lhr-solar/PS-PowerDistributionUnit/hardware/external_part/TPS2HCS08AQPWPRQ1/TPS2HCS08AQPWPRQ1.stp

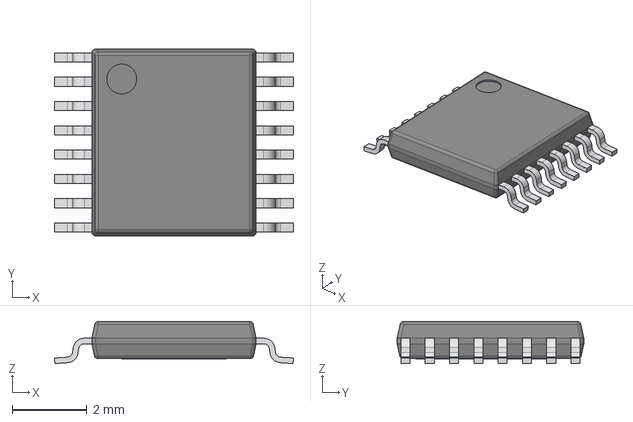
[picture p1: CAD file, 2026-11-02]
hardware/external_part/TPS2HCS08AQPWPRQ1/TPS2HCS08AQPWPRQ1.stp
6.40 x 5.00 x 1.13 mm
