lhr-solar/PS-PowerDistributionUnit/hardware/TestBoard_TPS27SA08-Q1/out/TestBoard_TPS27SA08-Q1.pdf

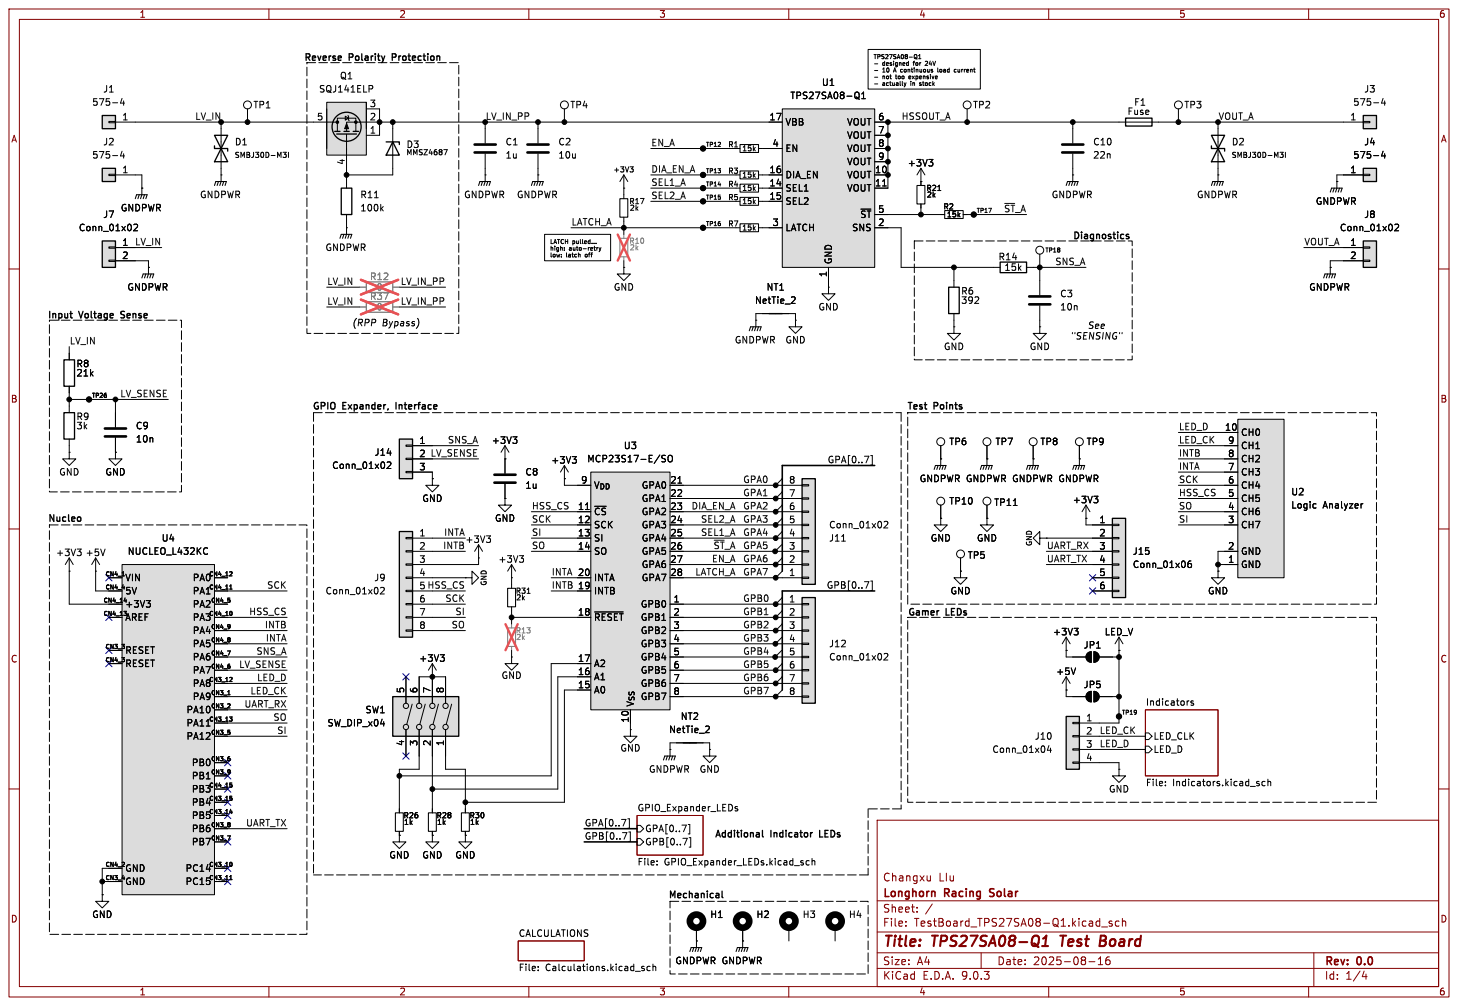
[picture p2: page 1]

LATCH pulled... high: auto-retry

LED_D
Logic Analyzer CH3 7 CH4 6 CH5 5 CH6 4 CH7 3 GND 2 GND 1 CH0 10 CH1 9 CH2 8 GND

V_{DD} 9 ~{CS} 11 SCK 12 SI 13 SO 14

Indicators File: Indicators.kicad_sch CALCULATIONS

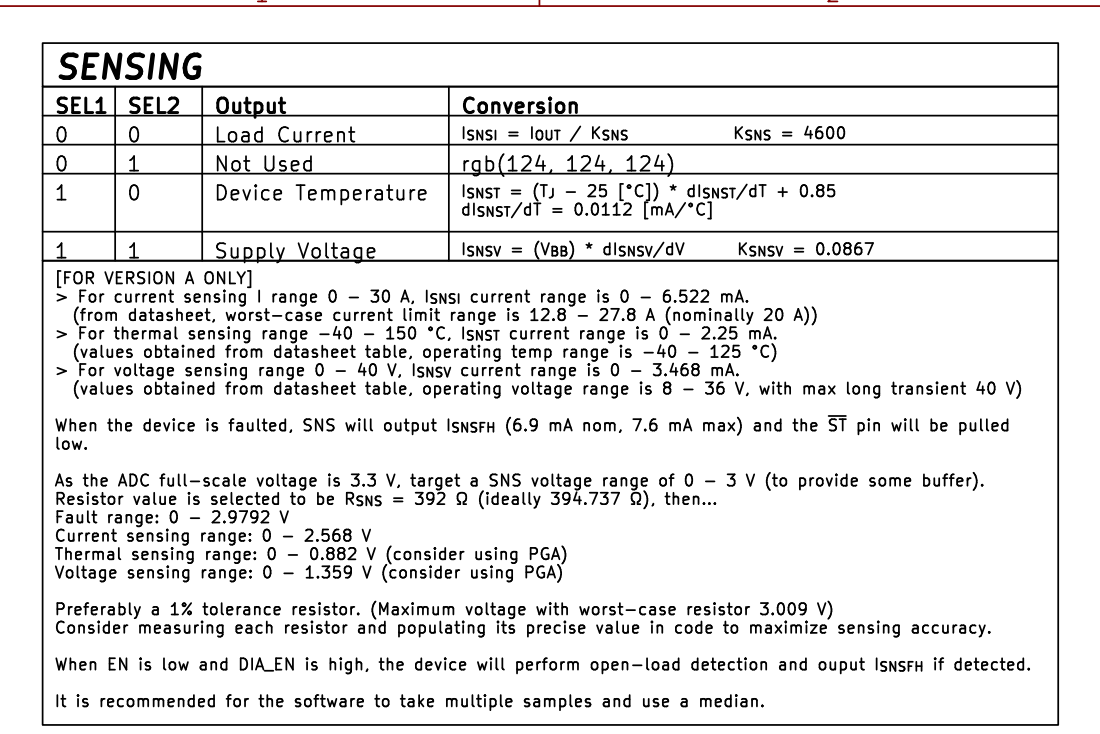
[picture p3: page 2]

1 | Supply Voltage | dI_{SNST}/dT= 0.0112 I_{SNSV} = (V_{BB})* dI_{SNSV}/dV þÿ[mA/°C] 1 K_{SNSV} = 0.0867 SENSING
SEL1 | SEL2 | Output | Conversion
0 | 0 1 0 | Load Current Not Used Device Temperature | I_{SNSI}= I_{OUT} / K_{SNS} rgb(124, I_{SNST} = (T_{J}- 25 124, 124) 1 | þÿ[°C]) * dI_{SNST}/dT+ 0.85 | K_{SNS}= 4600 0

Id: 2/4 Title: File: Calculations.kicad_sch Sheet: /CALCULATIONS/

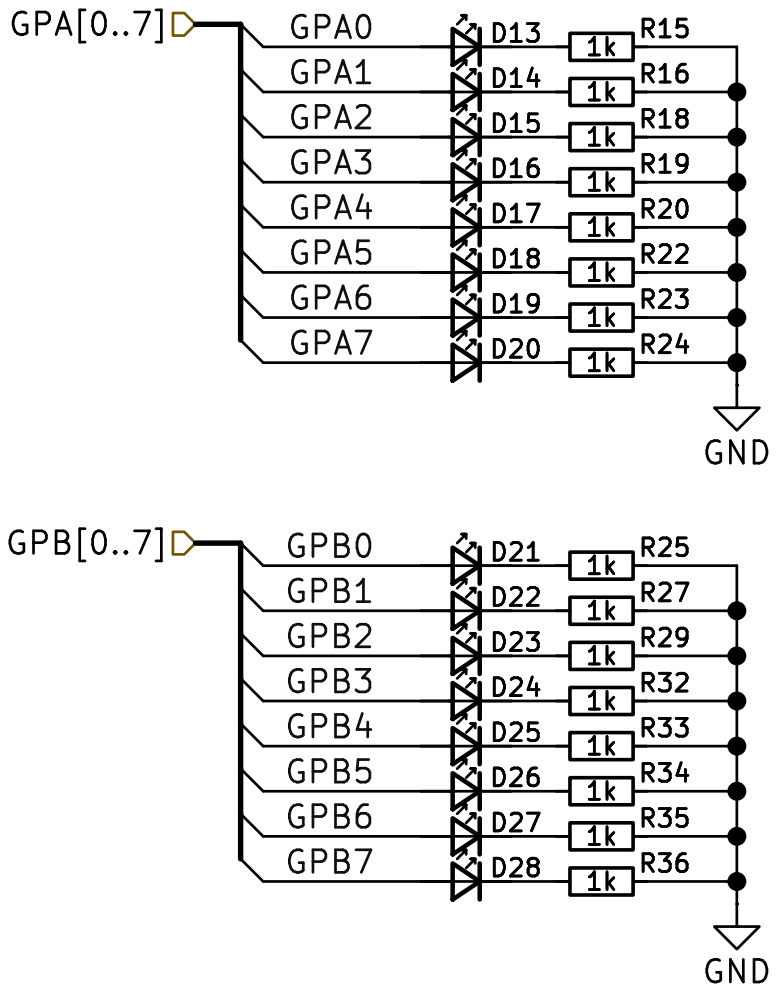
[picture p4: page 3]

Id: 4/4 Title: File: GPIO_Expander_LEDs.kicad_sch Sheet: /GPIO_Expander_LEDs/

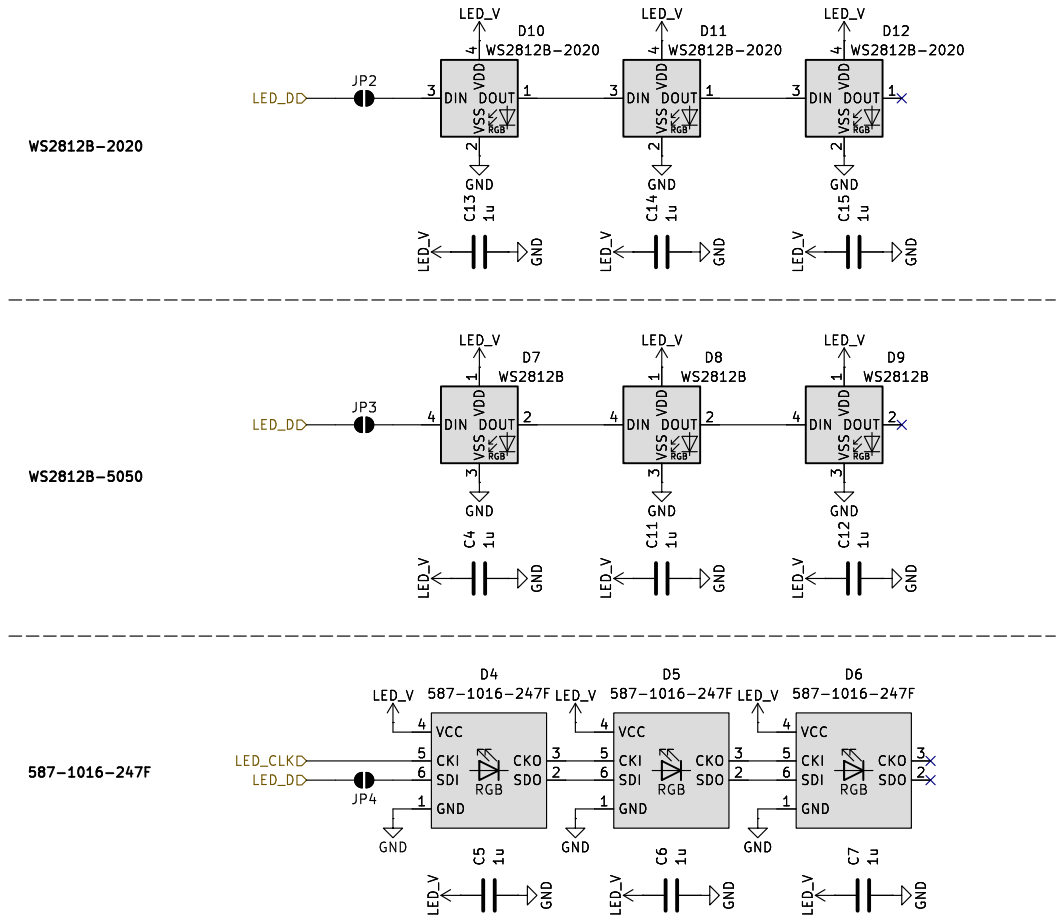
[picture p5: page 4]

Id: 3/4 Title: File: Indicators.kicad_sch Sheet: /Indicators/ LED_V
