lhr-solar/PS-PowerDistributionUnit/firmware/PowerDistributionUnit_Mk1/core/src/main.c

// main.c
// ----------------------------------------------------------------------------

// INCLUDES -------------------------------------------------------------------

#include "stm32xx_hal.h"
// stm32xx_hal.h contains includes for RTOS stuff.
#include<stdio.h>
#include<string.h>

// Tasks
#include "Task_Init.h"

// DEFINES --------------------------------------------------------------------

#define INTERVAL_BLINK_ERROR_MS 50

// DECLARATIONS ---------------------------------------------------------------

// SPI1
SPI_HandleTypeDef hspi1;                // Handle
SemaphoreHandle_t spi1_mutex;           // Mutex to prevent simultaneous SPI access
StaticSemaphore_t spi1_mutex_buffer;    // SPI mutex buffer
SemaphoreHandle_t spi1_done_sem;        // Semaphore to signal SPI IT completion
StaticSemaphore_t spi1_done_sem_buffer; // SPI completion sempahore buffer

// SPI2
SPI_HandleTypeDef hspi2;
SemaphoreHandle_t spi2_mutex;
StaticSemaphore_t spi2_mutex_buffer;
SemaphoreHandle_t spi2_done_sem;
StaticSemaphore_t spi2_done_sem_buffer;

// SPI3
SPI_HandleTypeDef hspi3;
SemaphoreHandle_t spi3_mutex;
StaticSemaphore_t spi3_mutex_buffer;
SemaphoreHandle_t spi3_done_sem;
StaticSemaphore_t spi3_done_sem_buffer;

// Task: Init
StaticTask_t init_task_buffer;                          // Task buffer
StackType_t init_task_stack[TASK_INIT_STACK_SIZE];      // Task stack

// MAIN -----------------------------------------------------------------------

int main()
{
    HAL_Init();
    SystemClock_Config();

    xTaskCreateStatic(Task_Init,
                    "Init Task",
                    TASK_INIT_STACK_SIZE,
                    NULL,
                    TASK_INIT_PRIORITY,
                    init_task_stack,
                    &init_task_buffer
                );

    vTaskStartScheduler();

    while(1) {}
}

// ERROR HANDLER --------------------------------------------------------------

void Error_Handler(void)
{
    while(1)
    {
        HAL_GPIO_TogglePin(LED_PORT, LED_PIN);
        vTaskDelay(pdMS_TO_TICKS(INTERVAL_BLINK_ERROR_MS));
    }
}
