lhr-solar/PS-PowerDistributionUnit/hardware/hardware.ioc

Mcu.UserName=STM32G473CETx
PA0.Signal=GPIO_Output
PA15.Signal=GPIO_Output
PA3.Signal=GPIO_Output
PA4.Signal=SPI1_NSS
PA5.Signal=SPI1_SCK
PA6.Signal=SPI1_MISO
PA7.Signal=SPI1_MOSI
PA8.Signal=GPIO_Output
PA9.Signal=GPIO_Output
PB0.Signal=GPIO_Output
PB1.Signal=GPIO_Output
PB10.Signal=GPIO_Output
PB11.Signal=GPIO_Output
PB12.Signal=FDCAN2_RX
PB13.Signal=FDCAN2_TX
PB3.Signal=GPIO_Output
PB4.Signal=GPIO_Output
PB6.Signal=GPIO_Output
PB7.Signal=GPIO_Output
PC13.Signal=GPIO_Output
PC14-OSC32_IN.Signal=GPIO_Output
