lhr-solar/PS-PowerDistributionUnit/firmware/PowerDistributionUnit_Mk1/core/src/PDU_Mk1_CurrentSensing.c

// PDU_Mk1_CurrentSensing.c

#include "PDU_Mk1_CurrentSensing.h"

ADS131M08Q1_HandleTypeDef adc_sns1;
ADS131M08Q1_HandleTypeDef adc_sns0;

float currents[PDU_MK1_NUM_CHANNELS] = {0};
float current_adc_v_offset[PDU_MK1_NUM_CHANNELS] = {0};

bool PDU_Mk1_CurrentSensing_Init()
{
#ifndef PDU_MK1_REV_A            // PDU_Mk1_REV_A has SPI pinout issue
    if(PDU_Mk1_Init_ADC_SNS0() != ADS131M08Q1_🙂)
    {
        return false;
    }
#endif

    if(PDU_Mk1_Init_ADC_SNS1() != ADS131M08Q1_🙂)
    {
        return false;
    }

    if(PDU_Mk1_CurrentSensing_CollectOffsets() != true)
    {
        return false;
    }

    return true;
}

ADS131M08Q1_Status_t PDU_Mk1_Init_ADC_SNS0()
{
    adc_sns0.spi = &hspi3;
    adc_sns0.cs_port = ADC_SNS0_CS_PORT;
    adc_sns0.cs_pin = ADC_SNS0_CS_PIN;

    adc_sns0.spi_mutex = spi3_mutex;
    adc_sns0.spi_done_sem = spi3_done_sem;
    
    for(uint8_t ch = 0; ch < ADS131M08Q1_NUM_CHANNELS; ch++)
    {
        adc_sns0.config.ch_configs[ch].enable = ADS131M08Q1_CH_ENABLE;
        adc_sns0.config.ch_configs[ch].gain = ADS131M08Q1_CH_GAIN_1;
        adc_sns0.config.ch_configs[ch].phase = ADS131M08Q1_CH_PHASE_DEFAULT;
        adc_sns0.config.ch_configs[ch].offset_cal = ADS131M08Q1_CH_OFFSET_CAL_DEFAULT;
        adc_sns0.config.ch_configs[ch].gain_cal = ADS131M08Q1_CH_GAIN_CAL_DEFAULT;
    }
    adc_sns0.config.drdy_format = ADS131M08Q1_CONFIG_DRDY_FORMAT_DEFAULT;
    adc_sns0.config.drdy_idlepinstate = ADS131M08Q1_CONFIG_DRDY_IDLEPINSTATE_DEFAULT;
    adc_sns0.config.drdy_source = ADS131M08Q1_CONFIG_DRDY_SOURCE_DEFAULT;
    adc_sns0.config.reference_source = ADS131M08Q1_CONFIG_REFERENCE_SOURCE_DEFAULT;
    adc_sns0.config.fsr = ADS131M08Q1_INTERNAL_REFERENCE_V;
    adc_sns0.config.powermode = ADS131M08Q1_CONFIG_POWERMODE_DEFAULT;

    return ADS131M08Q1_Init(&adc_sns0);
}

ADS131M08Q1_Status_t PDU_Mk1_Init_ADC_SNS1()
{
    adc_sns1.spi = &hspi2;
    adc_sns1.cs_port = ADC_SNS1_CS_PORT;
    adc_sns1.cs_pin = ADC_SNS1_CS_PIN;

    adc_sns1.spi_mutex = spi2_mutex;
    adc_sns1.spi_done_sem = spi2_done_sem;
    
    for(uint8_t ch = 0; ch < ADS131M08Q1_NUM_CHANNELS; ch++)
    {
        adc_sns1.config.ch_configs[ch].enable = ADS131M08Q1_CH_ENABLE;
        adc_sns1.config.ch_configs[ch].gain = ADS131M08Q1_CH_GAIN_1;
        adc_sns1.config.ch_configs[ch].phase = ADS131M08Q1_CH_PHASE_DEFAULT;
        adc_sns1.config.ch_configs[ch].offset_cal = ADS131M08Q1_CH_OFFSET_CAL_DEFAULT;
        adc_sns1.config.ch_configs[ch].gain_cal = ADS131M08Q1_CH_GAIN_CAL_DEFAULT;
    }
    adc_sns1.config.drdy_format = ADS131M08Q1_CONFIG_DRDY_FORMAT_DEFAULT;
    adc_sns1.config.drdy_idlepinstate = ADS131M08Q1_CONFIG_DRDY_IDLEPINSTATE_DEFAULT;
    adc_sns1.config.drdy_source = ADS131M08Q1_CONFIG_DRDY_SOURCE_DEFAULT;
    adc_sns1.config.reference_source = ADS131M08Q1_CONFIG_REFERENCE_SOURCE_DEFAULT;
    adc_sns1.config.fsr = ADS131M08Q1_INTERNAL_REFERENCE_V;
    adc_sns1.config.powermode = ADS131M08Q1_CONFIG_POWERMODE_DEFAULT;

    return ADS131M08Q1_Init(&adc_sns1);
}

bool PDU_Mk1_CurrentSensing_CollectOffsets()
{
    float adc_results_sns0[CURRENT_SENSING_OFFSET_CALC_NUMSAMPLES][ADS131M08Q1_NUM_CHANNELS] = {0};
    float adc_results_sns1[CURRENT_SENSING_OFFSET_CALC_NUMSAMPLES][ADS131M08Q1_NUM_CHANNELS] = {0};

    for(uint8_t sample = 0; sample < CURRENT_SENSING_OFFSET_CALC_NUMSAMPLES; sample++)
    {
#ifndef PDU_MK1_REV_A            // PDU_Mk1_REV_A has SPI pinout issue
        if(ADS131M08Q1_ReadConversionResults(&adc_sns0, adc_results_sns0[sample]) != ADS131M08Q1_🙂)
        {
            return false;
        }
#endif

        if(ADS131M08Q1_ReadConversionResults(&adc_sns1, adc_results_sns1[sample]) != ADS131M08Q1_🙂)
        {
            return false;
        }

        if(sample != CURRENT_SENSING_OFFSET_CALC_NUMSAMPLES-1)
        {
            vTaskDelay(pdMS_TO_TICKS(CURRENT_SENSING_OFFSET_CALC_SAMPLE_DELAY_MS));
        }
    }

    for(uint8_t ch = 0; ch < ADS131M08Q1_NUM_CHANNELS; ch++)
    {
        for(uint8_t sample = 0; sample < CURRENT_SENSING_OFFSET_CALC_NUMSAMPLES; sample++)
        {
            current_adc_v_offset[ch] += -1.0f*adc_results_sns1[sample][(ADS131M08Q1_NUM_CHANNELS-1)-ch];
            current_adc_v_offset[ADS131M08Q1_NUM_CHANNELS+ch] += -1.0f*adc_results_sns0[sample][(ADS131M08Q1_NUM_CHANNELS-1)-ch];
        }

        current_adc_v_offset[ch] /= (float) CURRENT_SENSING_OFFSET_CALC_NUMSAMPLES;
        current_adc_v_offset[ADS131M08Q1_NUM_CHANNELS+ch] /= (float) CURRENT_SENSING_OFFSET_CALC_NUMSAMPLES;
    }

    return true;
}

bool PDU_Mk1_CurrentSensing_ReadCurrents()
{
    float adc_results_sns0[ADS131M08Q1_NUM_CHANNELS] = {0};
    float adc_results_sns1[ADS131M08Q1_NUM_CHANNELS] = {0};

#ifndef PDU_MK1_REV_A            // PDU_Mk1_REV_A has SPI pinout issue
    if(ADS131M08Q1_ReadConversionResults(&adc_sns0, adc_results_sns0) != ADS131M08Q1_🙂)
    {
        return false;
    }
#endif

    if(ADS131M08Q1_ReadConversionResults(&adc_sns1, adc_results_sns1) != ADS131M08Q1_🙂)
    {
        return false;
    }

    for(uint8_t i = 0; i < ADS131M08Q1_NUM_CHANNELS; i++)
    {
        currents[i] = ACS3704x_010B3_Current_Conversion_QVOCentered(adc_results_sns1[(ADS131M08Q1_NUM_CHANNELS-1)-i]+current_adc_v_offset[i]);
        currents[ADS131M08Q1_NUM_CHANNELS+i] = ACS3704x_010B3_Current_Conversion_QVOCentered(adc_results_sns0[(ADS131M08Q1_NUM_CHANNELS-1)-i]+current_adc_v_offset[ADS131M08Q1_NUM_CHANNELS+i]);
    }

    return true;
}

float* PDU_Mk1_CurrentSensing_GetCurrentsPtr()
{
    return currents;
}

// reconfigure SPI when communicating with ADC as ADS131M08-Q1 has CPHA=1
bool ADS131M08Q1_ReconfigSPI(ADS131M08Q1_HandleTypeDef* device)
{
    if(device == &adc_sns0)
    {
        return PDU_Mk1_SPI3_ADC_Init();
    }
    else if(device == &adc_sns1)
    {
        return PDU_Mk1_SPI2_ADC_Init();
    }

    return false;
}
