lhr-solar/PS-PowerDistributionUnit/firmware/driver/inc/ADS131M08-Q1.h

// ADS131M08-Q1.h
// ----------------------------------------------------------------------------
// Driver for ADS131M08-Q1 24-bit simultaneously-sampling sigma-delta ADC
// Datasheet: datasheets/ADS131M08-Q1.pdf (from BBPDU repo root)

# pragma once

#include "stm32xx_hal.h"
#include<math.h>
#include<string.h>

#define ADS131M08Q1_SPI_MUTEX_DELAY_TICKS pdMS_TO_TICKS(1000)           // ticks
#define ADS131M08Q1_SPI_TRANSMISSION_DELAY_TICKS pdMS_TO_TICKS(100)   	// ticks
#define ADS131M08Q1_CS_DELAY_TICKS pdMS_TO_TICKS(1)						// ticks

#define ADS131M08Q1_NUM_CHANNELS 8
#define ADS131M08Q1_NUM_BITS 24
#define ADS131M08Q1_NUM_STEPS (8388608-1)   	// 2^23 (24 bits - 1 sign bit) - 1
#define ADS131M08Q1_INTERNAL_REFERENCE_V 1.2
#define ADS131M08Q1_CH_VALID_CHECK(ch) (ch < ADS131M08Q1_NUM_CHANNELS && ch >= 0)
#define ADS131M08Q1_CH_INVALID_CHECK(ch) (ch >= ADS131M08Q1_NUM_CHANNELS || ch < 0)

#define ADS131M08Q1_GAIN_CAL_MIN 0
#define ADS131M08Q1_GAIN_CAL_STEP 0.00000011920928955
#define ADS131M08Q1_GAIN_CAL_MAX 1.99999988079

#define ADS131M08Q1_WORD_SIZE 24
#define ADS131M08Q1_FRAME_LEN_24 10
#define ADS131M08Q1_FRAME_LEN_8 30 // (ADS131M08Q1_WORD_SIZE*ADS131M08Q1_FRAME_LEN_24)/8
#define ADS131M08Q1_WORD_LEN_8 3

#define ADS131M08Q1_OPCODE_NULL_MSB 0x00
#define ADS131M08Q1_OPCODE_NULL_LSB 0x00
#define ADS131M08Q1_OPCODE_RESET_MSB 0x00
#define ADS131M08Q1_OPCODE_RESET_LSB 0x11
#define ADS131M08Q1_OPCODE_STANDBY_MSB 0x00
#define ADS131M08Q1_OPCODE_STANDBY_LSB 0x22
#define ADS131M08Q1_OPCODE_WAKEUP_MSB 0x00
#define ADS131M08Q1_OPCODE_WAKEUP_LSB 0x33
#define ADS131M08Q1_OPCODE_LOCK_MSB 0x05
#define ADS131M08Q1_OPCODE_LOCK_LSB 0x55
#define ADS131M08Q1_OPCODE_UNLOCK_MSB 0x06
#define ADS131M08Q1_OPCODE_UNLOCK_LSB 0x55
#define ADS131M08Q1_OPCODE_RREG_MSB 0xA0
#define ADS131M08Q1_OPCODE_WREG_MSB 0x60

#define ADS131M08Q1_RESPONSE_RESET_MSB 0xFF
#define ADS131M08Q1_RESPONSE_RESET_LSB 0x28
#define ADS131M08Q1_RESPONSE_STANDBY_MSB 0x00
#define ADS131M08Q1_RESPONSE_STANDBY_LSB 0x22
#define ADS131M08Q1_RESPONSE_WAKEUP_MSB 0x00
#define ADS131M08Q1_RESPONSE_WAKEUP_LSB 0x33
#define ADS131M08Q1_RESPONSE_LOCK_MSB 0x05
#define ADS131M08Q1_RESPONSE_LOCK_LSB 0x55
#define ADS131M08Q1_RESPONSE_UNLOCK_MSB 0x06
#define ADS131M08Q1_RESPONSE_UNLOCK_LSB 0x55
#define ADS131M08Q1_RESPONSE_RREG_MSB 0xE0
#define ADS131M08Q1_RESPONSE_WREG_MSB 0x40

typedef enum {
	ADS131M08Q1_😢,				// ADS131M08Q1 sad
	ADS131M08Q1_🙂,				// ADS131M08Q1 happy
	ADS131M08Q1_🕷️,    		// ADS131M08Q1 SPI mutex timeout
	ADS131M08Q1_🕸️,			// ADS131M08Q1 SPI done semaphore timeout
} ADS131M08Q1_Status_t;

// REGISTERS -----------------------------------------------------------

#define ADS131M08Q1_REG_ID 0x00
#define ADS131M08Q1_REG_STATUS 0x01
#define ADS131M08Q1_REG_MODE 0x02
#define ADS131M08Q1_REG_CLOCK 0x03
#define ADS131M08Q1_REG_GAIN1 0x04
#define ADS131M08Q1_REG_GAIN2 0x05
#define ADS131M08Q1_REG_CFG 0x06
#define ADS131M08Q1_REG_THRSHLD_MSB 0x07
#define ADS131M08Q1_REG_THRSHLD_LSB 0x08
#define ADS131M08Q1_REG_REGMAP_CRC 0x3E
#define ADS131M08Q1_REG_CHx_CFG(x) (ADS131M08Q1_CH_VALID_CHECK(x) ? 0x09 + 5*x : 0x09)
#define ADS131M08Q1_REG_CHx_OCAL_MSB(x) (ADS131M08Q1_CH_VALID_CHECK(x) ? 0x0A + 5*x : 0x0A)
#define ADS131M08Q1_REG_CHx_OCAL_LSB(x) (ADS131M08Q1_CH_VALID_CHECK(x) ? 0x0B + 5*x : 0x0B)
#define ADS131M08Q1_REG_CHx_GCAL_MSB(x) (ADS131M08Q1_CH_VALID_CHECK(x) ? 0x0C + 5*x : 0x0C)
#define ADS131M08Q1_REG_CHx_GCAL_LSB(x) (ADS131M08Q1_CH_VALID_CHECK(x) ? 0x0D + 5*x : 0x0D)

#define ADS131M08Q1_REG_INVALID 0x3F
#define ADS131M08Q1_REG_INVALID_CHECK(reg_addr, num_regs) (reg_addr+num_regs-1) >= ADS131M08Q1_REG_INVALID || reg_addr < 0

#define ADS131M08Q1_REG_ID_VAL 0x28

// CONFIGTEMPLATEs are register default values, with fields to be set by Init function zeroed out
#define ADS131M08Q1_CONFIGTEMPLATE_MODE 0x0110      // MODE also has the "reset ocurred" bit cleared
#define ADS131M08Q1_CONFIGTEMPLATE_CLOCK 0x000C
#define ADS131M08Q1_CONFIGTEMPLATE_GAIN 0x0000
#define ADS131M08Q1_CONFIGTEMPLATE_CHx_CFG 0x0000

#define ADS131M08Q1_MODECONFIG_LSHIFT_DRDY_SOURCE 2
#define ADS131M08Q1_MODECONFIG_LSHIFT_DRDY_IDLEPINSTATE 1
#define ADS131M08Q1_MODECONFIG_LSHIFT_DRDY_FORMAT 0
#define ADS131M08Q1_CLOCKCONFIG_LSHIFT_CHx_ENABLE(x) (8+x)
#define ADS131M08Q1_CLOCKCONFIG_LSHIFT_REFERENCE_SOURCE 6
#define ADS131M08Q1_CLOCKCONFIG_LSHIFT_POWERMODE 0
#define ADS131M08Q1_GAINCONFIG_LSHIFT_CH0_CH4_GAIN 0
#define ADS131M08Q1_GAINCONFIG_LSHIFT_CH1_CH5_GAIN 4
#define ADS131M08Q1_GAINCONFIG_LSHIFT_CH2_CH6_GAIN 8
#define ADS131M08Q1_GAINCONFIG_LSHIFT_CH3_CH7_GAIN 12
#define ADS131M08Q1_CHCONFIG_CFG_LSHIFT_PHASE 6
#define ADS131M08Q1_CHCONFIG_CAL_MSB_RSHIFT 8
#define ADS131M08Q1_CHCONFIG_CAL_MSB_KEEPMASK 0x0000FFFF
#define ADS131M08Q1_CHCONFIG_CAL_LSB_LSHIFT 8

// CONFIGURATION --------------------------------------------------------------

typedef enum {
	ADS131M08Q1_CH_DISABLE,		// enable channel for use
	ADS131M08Q1_CH_ENABLE,		// disable channel
} ADS131M08Q1_Ch_Enable_t;
#define ADS131M08Q1_CH_ENABLE_DEFAULT 0b1
// TODO: change default defines to use enum

typedef enum {
	ADS131M08Q1_CH_GAIN_1,
	ADS131M08Q1_CH_GAIN_2,
	ADS131M08Q1_CH_GAIN_4,
	ADS131M08Q1_CH_GAIN_8,
	ADS131M08Q1_CH_GAIN_16,
	ADS131M08Q1_CH_GAIN_32,
	ADS131M08Q1_CH_GAIN_64,
	ADS131M08Q1_CH_GAIN_128,
} ADS131M08Q1_Ch_Gain_t;
#define ADS131M08Q1_CH_GAIN_DEFAULT 0b000

#define ADS131M08Q1_CH_PHASE_DEFAULT 0
#define ADS131M08Q1_CH_OFFSET_CAL_DEFAULT 0x00000000
#define ADS131M08Q1_CH_GAIN_CAL_DEFAULT 0x00800000

// ADC Channel Configuration Struct
typedef struct {
	ADS131M08Q1_Ch_Enable_t enable;
	ADS131M08Q1_Ch_Gain_t gain;
	int16_t phase;					// in modulator clock cycles
	int32_t offset_cal;				// range: -FSR to FSR (converted to same format as ADC data)
	uint32_t gain_cal;				// range: 0 - 2
	// DC block filter and input mux settings not implemented.
} ADS131M08Q1_ChannelConfig_t;

typedef enum {														// ADC DRDY indicate on...
	ADS131M08Q1_MOST_LAGGING_ENABLED_CHANNEL,						// most lagging enabled channel 
	ADS131M08Q1_LOGIC_OR_ALL_CHANNELS,								// logic OR on all channels
	ADS131M08Q1_MOST_LEADING_ENABLED_CHANNEL,						// most leading enabled channel
	ADS131M08Q1_MOST_LEADING_ENABLED_CHANNEL_2_ELECTRIC_BOOGALOO,	// (same as last one)
} ADS131M08Q1_Config_DRDY_Source_t;
#define ADS131M08Q1_CONFIG_DRDY_SOURCE_DEFAULT 0b00

typedef enum {														// ADC DRDY pin, when data not available, is...
	ADS131M08Q1_DRDY_LOGIC_HIGH,									// logic high
	ADS131M08Q1_DRDY_HIGH_Z,										// high-impedance (for open drain)
} ADS131M08Q1_Config_DRDY_IdlePinState_t;
#define ADS131M08Q1_CONFIG_DRDY_IDLEPINSTATE_DEFAULT 0b0

typedef enum {														// ADC DRDY pin, when data is available...
	ADS131M08Q1_DRDY_LOGIC_LOW,										// stays logic low	
	ADS131M08Q1_DRDY_LOW_PULSE_FIXED_DURATION,						// logic low for a fixed pulse duration
} ADS131M08Q1_Config_DRDY_Format_t;
#define ADS131M08Q1_CONFIG_DRDY_FORMAT_DEFAULT 0b0

typedef enum {
	ADS131M08Q1_REFERENCE_SOURCE_INTERNAL,							// Use internal voltage reference
	ADS131M08Q1_REFERENCE_SOURCE_EXTERNAL,							// Use external voltage reference
} ADS131M08Q1_Config_ReferenceSource_t;
#define ADS131M08Q1_CONFIG_REFERENCE_SOURCE_DEFAULT 0b0
#define ADS131M08Q1_CONFIG_FSR_DEFAULT 1.2

typedef enum {														// ADC power mode
	ADS131M08Q1_VERY_LOW_POWER,										// very low power
	ADS131M08Q1_LOW_POWER,											// low power
	ADS131M08Q1_HIGH_RESOLUTION,									// high resolution
	ADS131M08Q1_HIGH_RESOLUTION_2_THE_SEQUEL,						// (same as last one)
} ADS131M08Q1_Config_PowerMode_t;
#define ADS131M08Q1_CONFIG_POWERMODE_DEFAULT 0b10

// FOR FUTURE IMPLEMENTATION
// typedef enum {
//     ADS131M08Q1_MODE_CONTINUOUS_CONVERSION,
//     ADS131M08Q1_MODE_GLOBAL_CHOP,
//     ADS131M08Q1_MODE_STANDBY,
//     ADS131M08Q1_MODE_CURRENT_DETECT,
// } ADS131M08Q1_Config_OperatingMode_t;

// FOR FUTURE IMPLEMENTATION
// typedef enum {
//     ADS131M08Q1_GLOBALCHOP_DELAY_2,
//     ADS131M08Q1_GLOBALCHOP_DELAY_4,
//     ADS131M08Q1_GLOBALCHOP_DELAY_8,
//     ADS131M08Q1_GLOBALCHOP_DELAY_16,
//     ADS131M08Q1_GLOBALCHOP_DELAY_32,
//     ADS131M08Q1_GLOBALCHOP_DELAY_64,
//     ADS131M08Q1_GLOBALCHOP_DELAY_128,
//     ADS131M08Q1_GLOBALCHOP_DELAY_256,
//     ADS131M08Q1_GLOBALCHOP_DELAY_512,
//     ADS131M08Q1_GLOBALCHOP_DELAY_1024,
//     ADS131M08Q1_GLOBALCHOP_DELAY_2048,
//     ADS131M08Q1_GLOBALCHOP_DELAY_4096,
//     ADS131M08Q1_GLOBALCHOP_DELAY_8192,
//     ADS131M08Q1_GLOBALCHOP_DELAY_16384,
//     ADS131M08Q1_GLOBALCHOP_DELAY_32768,
//     ADS131M08Q1_GLOBALCHOP_DELAY_65536,
// }
// #define ADS131M08Q1_GLOBALCHOP_DELAY_DEFAULT 0x03

// ADC Device Init Config Struct
typedef struct {
	ADS131M08Q1_ChannelConfig_t ch_configs[8];
	ADS131M08Q1_Config_DRDY_Source_t drdy_source;
	ADS131M08Q1_Config_DRDY_IdlePinState_t drdy_idlepinstate;
	ADS131M08Q1_Config_DRDY_Format_t drdy_format;
	ADS131M08Q1_Config_ReferenceSource_t reference_source;
	float fsr;
	ADS131M08Q1_Config_PowerMode_t powermode;

	// FOR FUTURE IMPLEMENTATION
	// ADS131M08Q1_Config_OperatingMode mode;
	// ADS131M08Q1_GlobalChop_Delay gc_delay;
	// ADS131M08Q1_CurrentDetect_Delay cd_delay;
	// ADS131M08Q1_CurrentDetect_Threshold cd_threshold;
	// ADS131M08Q1_CurrentDetect_Chs cd_channels;
	// uint32_t current_detect_threshold;
} ADS131M08Q1_DeviceConfig_t;

// DEVICE ---------------------------------------------------------------------

typedef struct {
	SPI_HandleTypeDef* spi;     // STM32 HAL SPI handle
	GPIO_TypeDef* cs_port;
	uint16_t cs_pin;

	SemaphoreHandle_t spi_mutex;        // Mutex to prevent simultaenous SPI access
	SemaphoreHandle_t spi_done_sem;     // Semaphore to signal SPI transmission complete

	ADS131M08Q1_DeviceConfig_t config;
	float conversion_factor[ADS131M08Q1_NUM_CHANNELS];
} ADS131M08Q1_HandleTypeDef;


// DEVICE FUNCTIONS -----------------------------------------------------------
// meant to be used interally, but exposed for outside use if CAREFUL

/**
 * @brief	Transmits for one 10-word SPI frame.
 * @param	device ADS131M08Q1 Device Handle
 * @param	out_data Pointer (uint8_t array) to data to tramsit
 * @returns ADS131M08Q1 Status (ADS131M08Q1_🙂 if successful)
 */
ADS131M08Q1_Status_t ADS131M08Q1_Frame_Transmit(ADS131M08Q1_HandleTypeDef* device, uint8_t* out_data);

/**
 * @brief	Receives for one 10-word SPI frame.
 * @param	device ADS131M08Q1 Device Handle
 * @param	in_data Pointer (uint8_t array) to store received data
 * @returns ADS131M08Q1 Status (ADS131M08Q1_🙂 if successful)
 */
ADS131M08Q1_Status_t ADS131M08Q1_Frame_Receive(ADS131M08Q1_HandleTypeDef* device, uint8_t* in_data);

/**
 * @brief	Transmits and receives for one 10-word SPI frame.
 * @param	device ADS131M08Q1 Device Handle
 * @param	out_data Pointer (uint8_t array) to data to tramsit
 * @param	in_data Pointer (uint8_t array) to store received data
 * @returns ADS131M08Q1 Status (ADS131M08Q1_🙂 if successful)
 */
ADS131M08Q1_Status_t ADS131M08Q1_Frame_TransmitReceive(ADS131M08Q1_HandleTypeDef* device, uint8_t* out_data, uint8_t* in_data);

/**
 * @brief	Transmits for a variable-size SPI frame.
 * @param	device ADS131M08Q1 Device Handle
 * @param	out_data Pointer (uint8_t array) to data to tramsit
 * @param	num_words Number of 24-bit words to include in SPI frame
 * @returns ADS131M08Q1 Status (ADS131M08Q1_🙂 if successful)
 */
ADS131M08Q1_Status_t ADS131M08Q1_FrameVar_Transmit(ADS131M08Q1_HandleTypeDef* device, uint8_t* out_data, uint8_t num_words);

/**
 * @brief	Receives for a variable-size SPI frame.
 * @param	device ADS131M08Q1 Device Handle
 * @param	in_data Pointer (uint8_t array) to store received data
 * @param	num_words Number of 24-bit words to include in SPI frame
 * @returns ADS131M08Q1 Status (ADS131M08Q1_🙂 if successful)
 */
ADS131M08Q1_Status_t ADS131M08Q1_FrameVar_Receive(ADS131M08Q1_HandleTypeDef* device, uint8_t* in_data, uint8_t num_words);

/**
 * @brief	Transmits and receives for a variable-size SPI frame.
 * @param	device ADS131M08Q1 Device Handle
 * @param	out_data Pointer (uint8_t array) to data to tramsit
 * @param	in_data Pointer (uint8_t array) to store received data
 * @param	num_words Number of 24-bit words to include in SPI frame
 * @returns ADS131M08Q1 Status (ADS131M08Q1_🙂 if successful)
 */
ADS131M08Q1_Status_t ADS131M08Q1_FrameVar_TransmitReceive(ADS131M08Q1_HandleTypeDef* device, uint8_t* out_data, uint8_t* in_data, uint8_t num_words);

/**
 * @brief	Sends an SPI command to the ADC.
 * @param	device ADS131M08Q1 Device Handle
 * @param	cmd_MSB MSB of command to send
 * @param	cmd_LSB LSB of command to send
 * @param	response_MSB MSB of expected response to command
 * @param	response_LSB LSB of expected response to command
 * @param	response_delay_ms Time to wait between sending command before trying to get reponse (zero for most, mainly for RESET command)
 * @returns ADS131M08Q1 Status (ADS131M08Q1_🙂 if successful)
 */
ADS131M08Q1_Status_t ADS131M08Q1_SendCommand(ADS131M08Q1_HandleTypeDef* device, uint8_t cmd_MSB, uint8_t cmd_LSB, uint8_t response_MSB, uint8_t response_LSB, uint8_t response_delay_ms);

/**
 * @brief	Reads register(s) on ADC.
 * @param	device ADS131M08Q1 Device Handle
 * @param	reg_addr Starting register address
 * @param	data Pointer (uint16_t array) to store data read from register(s)
 * @param	num_regs Number of sequential register(s) to read
 * @returns ADS131M08Q1 Status (ADS131M08Q1_🙂 if successful)
 */
ADS131M08Q1_Status_t ADS131M08Q1_ReadRegs(ADS131M08Q1_HandleTypeDef* device, uint8_t reg_addr, uint16_t* data, uint8_t num_regs);

/**
 * @brief	Writes to register(s) on ADC.
 * @param	device ADS131M08Q1 Device Handle
 * @param	reg_addr Starting register address
 * @param	data Pointer (uint16_t array) to data to write to regster(s)
 * @param	num_regs Number of sequential register(s) to write
 * @returns ADS131M08Q1 Status (ADS131M08Q1_🙂 if successful)
 */
ADS131M08Q1_Status_t ADS131M08Q1_WriteRegs(ADS131M08Q1_HandleTypeDef* device, uint8_t reg_addr, uint16_t* data, uint8_t num_regs);

// USER FUNCTIONS -----------------------------------------------------------

/**
 * @brief	Initializes ADS131M08Q1 driver and configures device for use. Configuration 
 * 			should be written to config struct in device handle before calling.
 * @param	device ADS131M08Q1 Device Handle
 * @returns ADS131M08Q1 Status (ADS131M08Q1_🙂 if successful)
 */
ADS131M08Q1_Status_t ADS131M08Q1_Init(ADS131M08Q1_HandleTypeDef* device);

/**
 * @brief	Reads conversion results from ADC.
 * @param	device ADS131M08Q1 Device Handle
 * @param	results Pointer (float) to store conversion results
 * @returns ADS131M08Q1 Status (ADS131M08Q1_🙂 if successful)
 */
ADS131M08Q1_Status_t ADS131M08Q1_ReadConversionResults(ADS131M08Q1_HandleTypeDef* device, float* results);

/**
 * @brief	Reads ADC STATUS register.
 * @param	device ADS131M08Q1 Device Handle
 * @param	results Pointer (uint16_t) to store STATUS register contents
 * @returns ADS131M08Q1 Status (ADS131M08Q1_🙂 if successful)
 */
ADS131M08Q1_Status_t ADS131M08Q1_ReadStatus(ADS131M08Q1_HandleTypeDef* device, uint16_t* status);

/**
 * @brief	Reads ADC STATUS register and obtains conversion status for each channel.
 * @param	device ADS131M08Q1 Device Handle
 * @param	results Pointer (uint8_t) to store conversion statuses
 * @returns ADS131M08Q1 Status (ADS131M08Q1_🙂 if successful)
 */
ADS131M08Q1_Status_t ADS131M08Q1_ReadConversionStatus(ADS131M08Q1_HandleTypeDef* device, uint8_t* status);

/**
 * @brief	Resets ADC. All registers return to default value.
 * @param	device ADS131M08Q1 Device Handle
 * @returns ADS131M08Q1 Status (ADS131M08Q1_🙂 if successful)
 */
ADS131M08Q1_Status_t ADS131M08Q1_Reset(ADS131M08Q1_HandleTypeDef* device);

/**
 * @brief	Puts ADC into standby. Device ceases conversions.
 * @param	device ADS131M08Q1 Device Handle
 * @returns ADS131M08Q1 Status (ADS131M08Q1_🙂 if successful)
 */
ADS131M08Q1_Status_t ADS131M08Q1_Standby(ADS131M08Q1_HandleTypeDef* device);

/**
 * @brief	Pulls ADC out of standby. Device resumes conversions.
 * @param	device ADS131M08Q1 Device Handle
 * @returns ADS131M08Q1 Status (ADS131M08Q1_🙂 if successful)
 */
ADS131M08Q1_Status_t ADS131M08Q1_Wakeup(ADS131M08Q1_HandleTypeDef* device);

/**
 * @brief	Locks ADC SPI interface (with exception to NULL (read conversion results), 
 * 			UNLOCK, and read register commands).
 * @param	device ADS131M08Q1 Device Handle
 * @returns ADS131M08Q1 Status (ADS131M08Q1_🙂 if successful)
 */
ADS131M08Q1_Status_t ADS131M08Q1_Lock(ADS131M08Q1_HandleTypeDef* device);

/**
 * @brief	Unlocks ADC SPI interface.
 * @param	device ADS131M08Q1 Device Handle
 * @returns ADS131M08Q1 Status (ADS131M08Q1_🙂 if successful)
 */
ADS131M08Q1_Status_t ADS131M08Q1_Unlock(ADS131M08Q1_HandleTypeDef* device);

// SPI CONFIGURATION FUNCTIONS ----------------------------------------------------

/**
 * @brief	Reconfigures SPI before communicating with device, for if multiple
 * 			devices on the same SPI bus require different settings. Weakly
 * 			defined. Should NOT be called outside of driver or could disrupt
 * 			communications with other devices. (Driver only calls once SPI
 * 			mutex is taken.)
 * @param	device ADS131M08Q1 Device Handle
 * @returns	bool (true if successful)
 */
bool ADS131M08Q1_ReconfigSPI(ADS131M08Q1_HandleTypeDef* device);

// HELPER FUNCTIONS -----------------------------------------------------------

/**
 * @brief	Calculates the offset calibration register value to apply a voltage offset 
 * 			to a channel reading. This will need to be written into the offset calibration 
 * 			register using a separate function.
 * @param	device ADS131M08Q1 Device Handle (used to get FSR)
 * @param	offset Desired gain
 * @returns Offset calibration register value
 */
int32_t ADS131M08Q1_CalcOffsetCalRegValue(ADS131M08Q1_HandleTypeDef* device, float offset);

/**
 * @brief	Calculates the gain calibration register value to apply a voltage gain 
 * 			to a channel reading. This will need to be written into the gain calibration 
 * 			register using a separate function.
 * @param	device ADS131M08Q1 Device Handle (used to get FSR)
 * @param	offset Desired gain
 * @returns Gain calibration register value
 */
uint32_t ADS131M08Q1_CalcGainCalRegValue(ADS131M08Q1_HandleTypeDef* device, float gain);

// TODO
// ADS131M08Q1_Status_t ADDS131M08Q1_SetPowerMode(ADS131M08Q1_Config_PowerMode powermode);
// self calibration function
// global chop? current detect?
// global chop might not be usable due to lower negative voltage limits
// resetHappened
// SPI locked? Standby? 
// function to write to offset/gain calibration registers outside of init
