lhr-solar/PS-PowerDistributionUnit/firmware/PowerDistributionUnit_Mk1/core/src/PDU_Mk1_CAN.c

// PDU_Mk1_CAN.c

#include "PDU_Mk1_CAN.h"

#define FDCAN_NVIC_PRIO configLIBRARY_MAX_SYSCALL_INTERRUPT_PRIORITY + 3

uint32_t HAL_RCC_FDCAN_CLK_ENABLED = 0;

can_status_t PDU_Mk1_CAN_Init()
{
	can_status_t status;
	hfdcan3->Instance = FDCAN3;
	hfdcan3->Init.ClockDivider = FDCAN_CLOCK_DIV1;
	hfdcan3->Init.FrameFormat = FDCAN_FRAME_CLASSIC;
#ifdef PDU_MK1_CAN_DEV_EXTLOOPBACK
	hfdcan3->Init.Mode = FDCAN_MODE_EXTERNAL_LOOPBACK;
#else
	hfdcan3->Init.Mode = FDCAN_MODE_NORMAL;
#endif
	hfdcan3->Init.AutoRetransmission = ENABLE;
	hfdcan3->Init.TransmitPause = DISABLE;
	hfdcan3->Init.ProtocolException = DISABLE;
	hfdcan3->Init.NominalPrescaler = 20;
	hfdcan3->Init.NominalSyncJumpWidth = 1;
	hfdcan3->Init.NominalTimeSeg1 = 13;
	hfdcan3->Init.NominalTimeSeg2 = 2;
	hfdcan3->Init.DataPrescaler = 1;
	hfdcan3->Init.DataSyncJumpWidth = 1;
	hfdcan3->Init.DataTimeSeg1 = 1;
	hfdcan3->Init.DataTimeSeg2 = 1;
	hfdcan3->Init.StdFiltersNbr = 1;
	hfdcan3->Init.ExtFiltersNbr = 0;
	hfdcan3->Init.TxFifoQueueMode = FDCAN_TX_FIFO_OPERATION;

	// FDCAN1 Filter Config
	FDCAN_FilterTypeDef sFilterConfig;
	sFilterConfig.IdType = FDCAN_STANDARD_ID;
	sFilterConfig.FilterIndex = 0;
	sFilterConfig.FilterType = FDCAN_FILTER_MASK;
	sFilterConfig.FilterConfig = FDCAN_FILTER_TO_RXFIFO0; // directs frames to FIFO0
	sFilterConfig.FilterID1 = 0x000;
	sFilterConfig.FilterID2 = 0x000;

	status = can_fd_init(hfdcan3, &sFilterConfig);
	if(status != CAN_OK)
	{
		return status;
	}

	status = can_fd_start(hfdcan3);
	if(status != CAN_OK){
		return status;
	}

	return CAN_OK;
}

void HAL_FDCAN_MspInit(FDCAN_HandleTypeDef* fdcanHandle)
{

  GPIO_InitTypeDef GPIO_InitStruct = {0};
  RCC_PeriphCLKInitTypeDef PeriphClkInit = {0};

  if(0){ // placeholder for if else if there are no FDCANs defined

  }
#ifdef FDCAN1
  else if(fdcanHandle->Instance==FDCAN1)
  {
 
	PeriphClkInit.PeriphClockSelection = RCC_PERIPHCLK_FDCAN;
	PeriphClkInit.FdcanClockSelection = RCC_FDCANCLKSOURCE_PCLK1;
	if (HAL_RCCEx_PeriphCLKConfig(&PeriphClkInit) != HAL_OK)
	{
	  Error_Handler();
	}

	/* FDCAN1 clock enable */
	HAL_RCC_FDCAN_CLK_ENABLED++;
	if(HAL_RCC_FDCAN_CLK_ENABLED==1){
	  __HAL_RCC_FDCAN_CLK_ENABLE();
	}

	__HAL_RCC_GPIOA_CLK_ENABLE();
	/**FDCAN1 GPIO Configuration
	PA11     ------> FDCAN1_RX
	PA12     ------> FDCAN1_TX
	*/ 
	GPIO_InitStruct.Pin = GPIO_PIN_11|GPIO_PIN_12;
	GPIO_InitStruct.Mode = GPIO_MODE_AF_PP;
	GPIO_InitStruct.Pull = GPIO_NOPULL;
	GPIO_InitStruct.Speed = GPIO_SPEED_FREQ_LOW;
	GPIO_InitStruct.Alternate = GPIO_AF9_FDCAN1;
	HAL_GPIO_Init(GPIOA, &GPIO_InitStruct);

	/* FDCAN1 interrupt Init */
	HAL_NVIC_SetPriority(FDCAN1_IT0_IRQn, FDCAN_NVIC_PRIO, 0);
	HAL_NVIC_EnableIRQ(FDCAN1_IT0_IRQn);
	HAL_NVIC_SetPriority(FDCAN1_IT1_IRQn, FDCAN_NVIC_PRIO, 0);
	HAL_NVIC_EnableIRQ(FDCAN1_IT1_IRQn);
  }
#endif // FDCAN1
#ifdef FDCAN2
  else if(fdcanHandle->Instance==FDCAN2)
  {

	PeriphClkInit.PeriphClockSelection = RCC_PERIPHCLK_FDCAN;
	PeriphClkInit.FdcanClockSelection = RCC_FDCANCLKSOURCE_PCLK1;
	if (HAL_RCCEx_PeriphCLKConfig(&PeriphClkInit) != HAL_OK)
	{
	  Error_Handler();
	}

	/* FDCAN2 clock enable */
	HAL_RCC_FDCAN_CLK_ENABLED++;
	if(HAL_RCC_FDCAN_CLK_ENABLED==1){
	  __HAL_RCC_FDCAN_CLK_ENABLE();
	}

	__HAL_RCC_GPIOB_CLK_ENABLE();
	/**FDCAN2 GPIO Configuration
	PB12     ------> FDCAN2_RX
	PB13     ------> FDCAN2_TX
	*/
	GPIO_InitStruct.Pin = GPIO_PIN_12|GPIO_PIN_13;
	GPIO_InitStruct.Mode = GPIO_MODE_AF_PP;
	GPIO_InitStruct.Pull = GPIO_NOPULL;
	GPIO_InitStruct.Speed = GPIO_SPEED_FREQ_LOW;
	GPIO_InitStruct.Alternate = GPIO_AF9_FDCAN2;
	HAL_GPIO_Init(GPIOB, &GPIO_InitStruct);

	/* FDCAN2 interrupt Init */
	HAL_NVIC_SetPriority(FDCAN2_IT0_IRQn, FDCAN_NVIC_PRIO, 0);
	HAL_NVIC_EnableIRQ(FDCAN2_IT0_IRQn);
	HAL_NVIC_SetPriority(FDCAN2_IT1_IRQn, FDCAN_NVIC_PRIO, 0);
	HAL_NVIC_EnableIRQ(FDCAN2_IT1_IRQn);
  
  }
#endif // FDCAN2

#ifdef FDCAN3
  else if(fdcanHandle->Instance==FDCAN3)
  {
  /** Initializes the peripherals clocks
  */
	PeriphClkInit.PeriphClockSelection = RCC_PERIPHCLK_FDCAN;
	PeriphClkInit.FdcanClockSelection = RCC_FDCANCLKSOURCE_PCLK1;
	if (HAL_RCCEx_PeriphCLKConfig(&PeriphClkInit) != HAL_OK)
	{
	  Error_Handler();
	}

	/* FDCAN3 clock enable */
	HAL_RCC_FDCAN_CLK_ENABLED++;
	if(HAL_RCC_FDCAN_CLK_ENABLED==1){
	  __HAL_RCC_FDCAN_CLK_ENABLE();
	}

	__HAL_RCC_GPIOA_CLK_ENABLE();
	/**FDCAN3 GPIO Configuration
	PA8     ------> FDCAN3_RX
	PA15     ------> FDCAN3_TX
	*/
	GPIO_InitStruct.Pin = GPIO_PIN_8|GPIO_PIN_15;
	GPIO_InitStruct.Mode = GPIO_MODE_AF_PP;
	GPIO_InitStruct.Pull = GPIO_NOPULL;
	GPIO_InitStruct.Speed = GPIO_SPEED_FREQ_LOW;
	GPIO_InitStruct.Alternate = GPIO_AF11_FDCAN3;
	HAL_GPIO_Init(GPIOA, &GPIO_InitStruct);

	/* FDCAN3 interrupt Init */
	HAL_NVIC_SetPriority(FDCAN3_IT0_IRQn, FDCAN_NVIC_PRIO, 0);
	HAL_NVIC_EnableIRQ(FDCAN3_IT0_IRQn);
	HAL_NVIC_SetPriority(FDCAN3_IT1_IRQn, FDCAN_NVIC_PRIO, 0);
	HAL_NVIC_EnableIRQ(FDCAN3_IT1_IRQn);
  }
#endif
}
