lhr-solar/PS-PowerDistributionUnit/firmware/driver/inc/ShiftRegister_SPI.h

// ShiftRegister_SPI.h
// ----------------------------------------------------------------------------
// Driver for shift register(s) with shift and output registers that make use
// of shared active-low shift register reset and output register reset pins. 
// Ex: 74LVC594A
// Uses SPI for fast, non-blocking shifting (instead of bit-banging).

#pragma once

#include "stm32xx_hal.h"

#define SR_SPI_MUTEX_DELAY_TICKS pdMS_TO_TICKS(1000)
#define SR_SPI_TRANSMISSION_DELAY_TICKS pdMS_TO_TICKS(100)
#define SR_SPI_EN_DELAY_TICKS pdMS_TO_TICKS(1)
#define SR_SPI_INITIAL_ALL_OFF_DELAY_TICKS pdMS_TO_TICKS(1)

typedef enum {
	SR_SPI_😢,				// ShiftRegister_SPI sad
	SR_SPI_🙂,				// ShiftRegister_SPI happy
	SR_SPI_🕷️,    		    // ShiftRegister_SPI SPI mutex timeout
	SR_SPI_🕸️,			    // ShiftRegister_SPI_ SPI done semaphore timeout
} ShiftRegister_SPI_Status_t;

typedef struct {
	SPI_HandleTypeDef* spi;             // STM32 HAL SPI handle
	GPIO_TypeDef* en_port;              // enables SPI CLK to reach SR
	uint16_t en_pin;                    // like CS, but active-high

    GPIO_TypeDef* out_clk_port;         // out clk moves SR contents to output reg
	uint16_t out_clk_pin;

    GPIO_TypeDef* all_off_port;         // turns off all SR outputs
	uint16_t all_off_pin;

	SemaphoreHandle_t spi_mutex;        // Mutex to prevent simultaenous SPI access
	SemaphoreHandle_t spi_done_sem;     // Semaphore to signal SPI transmission complete

    uint8_t* data;                      // pointer to SR values
    uint8_t num_bytes;
} ShiftRegister_SPI_HandleTypeDef;

/**
 * @brief	Initializes shift register driver by checking handle values and
 * 			clearing shift register. Hardware (SPI, pins in handle) should 
 * 			be configured and initialized before calling. 
 * @param	device Shift Register Device Handle
 * @returns Shift Register Status (SR_SPI_🙂 if successful)
 */
ShiftRegister_SPI_Status_t SR_SPI_Init(ShiftRegister_SPI_HandleTypeDef* sr);

/**
 * @brief	Updates shift register(s). 
 * @param	device Shift Register Device Handle
 * @returns Shift Register Status (SR_SPI_🙂 if successful)
 */
ShiftRegister_SPI_Status_t SR_SPI_SetRegs(ShiftRegister_SPI_HandleTypeDef* sr);

/**
 * @brief	Assets All Off pin on shift registers - all register values and 
 * 			outputs go low. 
 * @param	device Shift Register Device Handle
 * @returns None
 */
void SR_SPI_Assert_AllOff(ShiftRegister_SPI_HandleTypeDef* sr);

/**
 * @brief	Deassets All Off pin on shift registers - data may now be shifted 
 * 			in. 
 * @param	device Shift Register Device Handle
 * @returns None
 */
void SR_SPI_Deassert_AllOff(ShiftRegister_SPI_HandleTypeDef* sr);

// SPI CONFIGURATION FUNCTIONS ------------------------------------------------

/**
 * @brief	Reconfigures SPI before communicating with device, for if multiple
 * 			devices on the same SPI bus require different settings. Weakly
 * 			defined. Should NOT be called outside of driver or could disrupt
 * 			communications with other devices. (Driver only calls once SPI
 * 			mutex is taken.)
 * @param	device Shift Register Device Handle
 * @returns bool (true if successful)
 */
bool SR_SPI_ReconfigSPI(ShiftRegister_SPI_HandleTypeDef* device);
