lhr-solar/PS-PowerDistributionUnit/firmware/PowerDistributionUnit_Mk1/tasks/inc/Task_CanSendStatus.h

// Task_ReadCurrents.h
// ----------------------------------------------------------------------------
// Task sends PDU status on CAN. 

#pragma once

// INCLUDES -------------------------------------------------------------------

#include "stm32xx_hal.h"
#include "printf.h"

#include "PDU_Mk1.h"
#include "PDU_Mk1_CAN.h"
#include "PDU_Mk1_CurrentSensing.h"
#include "PDU_Mk1_HSSControl.h"
#ifdef PDU_MK1_SDLOG_ERRORS
 #include "PDU_Mk1_SDCard.h"
#endif

// DEFINES --------------------------------------------------------------------

#define TASK_CANSENDSTATUS_STACK_SIZE configMINIMAL_STACK_SIZE+200
#define TASK_CANSENDSTATUS_PRIORITY tskIDLE_PRIORITY + 2

// sets how often the CAN status is sent
#define TASK_CANSENDSTATUS_CH_INTERVAL_MS 100		// single channel mode
// #define TASK_CANSENDSTATUS_INTERVAL_MS 1000		// spam all channels (doesn't work)

// VARIABLE DECLARATIONS ------------------------------------------------------

extern float lv_voltage;

// FUNCTIONS ------------------------------------------------------------------

void Task_CanSendStatus(void *argument);
