lhr-solar/PS-PowerDistributionUnit/firmware/PowerDistributionUnit_Mk1/core/inc/PDU_Mk1.h

// PDU_Mk1.h
// ----------------------------------------------------------------------------
// BBPDU Mk1 constants and stuff

#pragma once

#define PDU_MK1_NUM_CHANNELS 16

#define PDU_MK1_REV_A true
