lhr-solar/PS-PowerDistributionUnit/firmware/PowerDistributionUnit_Mk1/core/inc/PDU_Mk1_OutputConfig.h

#define HSSCONTROL_NONCRITICAL 0
#define HSSCONTROL_CRITICAL 1

#define HSSCONTROL_OUT0_PRIORITY HSSCONTROL_NONCRITICAL
#define HSSCONTROL_OUT1_PRIORITY HSSCONTROL_NONCRITICAL
#define HSSCONTROL_OUT2_PRIORITY HSSCONTROL_CRITICAL
#define HSSCONTROL_OUT3_PRIORITY HSSCONTROL_NONCRITICAL
#define HSSCONTROL_OUT4_PRIORITY HSSCONTROL_NONCRITICAL
#define HSSCONTROL_OUT5_PRIORITY HSSCONTROL_NONCRITICAL
#define HSSCONTROL_OUT6_PRIORITY HSSCONTROL_CRITICAL
#define HSSCONTROL_OUT7_PRIORITY HSSCONTROL_CRITICAL
#define HSSCONTROL_OUT8_PRIORITY HSSCONTROL_NONCRITICAL
#define HSSCONTROL_OUT9_PRIORITY HSSCONTROL_CRITICAL
#define HSSCONTROL_OUT10_PRIORITY HSSCONTROL_NONCRITICAL
#define HSSCONTROL_OUT11_PRIORITY HSSCONTROL_NONCRITICAL
#define HSSCONTROL_OUT12_PRIORITY HSSCONTROL_NONCRITICAL
#define HSSCONTROL_OUT13_PRIORITY HSSCONTROL_NONCRITICAL
#define HSSCONTROL_OUT14_PRIORITY HSSCONTROL_CRITICAL
#define HSSCONTROL_OUT15_PRIORITY HSSCONTROL_NONCRITICAL
