lhr-solar/PS-PowerDistributionUnit/firmware/PowerDistributionUnit_Mk1/core/inc/PDU_Mk1_GPIO.h

// PDU_Mk1_GPIO.h
// ----------------------------------------------------------------------------
// BBPDU Mk1 GPIO configuration

#pragma once

#include "stm32xx_hal.h"

#include "PDU_Mk1_Pins.h"

void PDU_Mk1_GPIO_Init(void);
