lhr-solar/PS-PowerDistributionUnit/firmware/PowerDistributionUnit_Mk1/core/inc/PDU_Mk1_UART.h

// PDU_Mk1_UART.h
// ----------------------------------------------------------------------------
// BBPDU Mk1 UART configuration

#pragma once

#include "stm32xx_hal.h"
#include "printf.h"

extern UART_HandleTypeDef* husart3;

bool PDU_Mk1_UART_Printf_Init(void);
