lhr-solar/PS-PowerDistributionUnit/firmware/PowerDistributionUnit_Mk1/core/src/PDU_Mk1_UART.c

// PDU_Mk1_UART.c

#include "PDU_Mk1_UART.h"

bool PDU_Mk1_UART_Printf_Init(void)
{
    // Init UART printf
    husart3->Init.BaudRate = 115200;
    husart3->Init.WordLength = UART_WORDLENGTH_8B;
    husart3->Init.StopBits = UART_STOPBITS_1;
    husart3->Init.Parity = UART_PARITY_NONE;
    husart3->Init.Mode = UART_MODE_TX_RX;
    husart3->Init.HwFlowCtl = UART_HWCONTROL_NONE;
    husart3->Init.OverSampling = UART_OVERSAMPLING_16;

    return printf_init(husart3);
}

/**
  * @brief UART MSP Initialization
  * This function configures the hardware resources used in this example
  * @param huart: UART handle pointer
  * @retval None
  */
void HAL_UART_MspGPIOInit(UART_HandleTypeDef* huart)
{
  GPIO_InitTypeDef GPIO_InitStruct = {0};
  RCC_PeriphCLKInitTypeDef PeriphClkInit = {0};
  if(huart->Instance==USART3)
  {
  /** Initializes the peripherals clocks
  */
    PeriphClkInit.PeriphClockSelection = RCC_PERIPHCLK_USART3;
    PeriphClkInit.Usart3ClockSelection = RCC_USART3CLKSOURCE_PCLK1;
    if (HAL_RCCEx_PeriphCLKConfig(&PeriphClkInit) != HAL_OK)
    {
      Error_Handler();
    }

    /* Peripheral clock enable */
    __HAL_RCC_USART3_CLK_ENABLE();

    __HAL_RCC_GPIOB_CLK_ENABLE();
    __HAL_RCC_GPIOC_CLK_ENABLE();
    /**USART3 GPIO Configuration
    PB10     ------> USART3_TX
    PC11     ------> USART3_RX
    */
    GPIO_InitStruct.Pin = GPIO_PIN_10;
    GPIO_InitStruct.Mode = GPIO_MODE_AF_PP;
    GPIO_InitStruct.Pull = GPIO_NOPULL;
    GPIO_InitStruct.Speed = GPIO_SPEED_FREQ_LOW;
    GPIO_InitStruct.Alternate = GPIO_AF7_USART3;
    HAL_GPIO_Init(GPIOB, &GPIO_InitStruct);

    GPIO_InitStruct.Pin = GPIO_PIN_11;
    GPIO_InitStruct.Mode = GPIO_MODE_AF_PP;
    GPIO_InitStruct.Pull = GPIO_NOPULL;
    GPIO_InitStruct.Speed = GPIO_SPEED_FREQ_LOW;
    GPIO_InitStruct.Alternate = GPIO_AF7_USART3;
    HAL_GPIO_Init(GPIOC, &GPIO_InitStruct);
  }

}
