lhr-solar/PS-PowerDistributionUnit/firmware/TestBoard_TPS27SA08-Q1/core/inc/TestBoard_TPS27SA08-Q1_Pins.h

#define LED_PIN GPIO_PIN_3
#define LED_PORT GPIOB
#define LED_CLOCK_INIT() __HAL_RCC_GPIOB_CLK_ENABLE();

#define VCP_TX_PIN GPIO_PIN_2
#define VCP_TX_PORT GPIOA
#define VCP_RX_PIN GPIO_PIN_15
#define VCP_RX_PORT GPIOA

#define GPIOEXP_CS_PIN GPIO_PIN_3
#define GPIOEXP_CS_PORT GPIOA

#define GPIOEXP_INTA_PIN GPIO_PIN_5
#define GPIOEXP_INTA_PORT GPIOA
