lhr-solar/PS-PowerDistributionUnit/firmware/TestBoard_TPS27SA08-Q1/core/src/main.c

// main.c

// INCLUDES -------------------------------------------------------------------


// DEFINES --------------------------------------------------------------------


// CONFIGURATION HANDLES/STRUCTS ----------------------------------------------


// FUNCTION DECLARATIONS ------------------------------------------------------


// GLOBAL VARIABLES -----------------------------------------------------------


int main()
{
	return 0;
}
