lhr-solar/PS-PowerDistributionUnit/firmware/TestBoard_TPS27SA08-Q1/core/src/TestBoard_TPS27SA08-Q1_UART.c

#include "TestBoard_TPS27SA08-Q1_UART.h"

void MX_USART2_UART_Init(void)
{
	huart2.Instance = USART2;
	huart2.Init.BaudRate = 115200;
	huart2.Init.WordLength = UART_WORDLENGTH_8B;
	huart2.Init.StopBits = UART_STOPBITS_1;
	huart2.Init.Parity = UART_PARITY_NONE;
	huart2.Init.Mode = UART_MODE_TX_RX;
	huart2.Init.HwFlowCtl = UART_HWCONTROL_NONE;
	huart2.Init.OverSampling = UART_OVERSAMPLING_16;
	huart2.Init.OneBitSampling = UART_ONE_BIT_SAMPLE_DISABLE;
	huart2.AdvancedInit.AdvFeatureInit = UART_ADVFEATURE_NO_INIT;
	if (HAL_UART_Init(&huart2) != HAL_OK)
	{
		Error_Handler();
	}
}

void HAL_UART_MspGPIOInit(UART_HandleTypeDef* huart)
{
	GPIO_InitTypeDef GPIO_InitStruct = {0};
	RCC_PeriphCLKInitTypeDef PeriphClkInit = {0};
	if(huart->Instance==USART2)
	{
		/** Initializes the peripherals clock */
		PeriphClkInit.PeriphClockSelection = RCC_PERIPHCLK_USART2;
		PeriphClkInit.Usart2ClockSelection = RCC_USART2CLKSOURCE_PCLK1;
		if (HAL_RCCEx_PeriphCLKConfig(&PeriphClkInit) != HAL_OK)
		{
		Error_Handler();
		}

		/* Peripheral clock enable */
		__HAL_RCC_USART2_CLK_ENABLE();

		__HAL_RCC_GPIOA_CLK_ENABLE();
		/**USART2 GPIO Configuration
		PA2     ------> USART2_TX
		PA15 (JTDI)     ------> USART2_RX
		*/
		GPIO_InitStruct.Pin = VCP_TX_PIN;
		GPIO_InitStruct.Mode = GPIO_MODE_AF_PP;
		GPIO_InitStruct.Pull = GPIO_NOPULL;
		GPIO_InitStruct.Speed = GPIO_SPEED_FREQ_VERY_HIGH;
		GPIO_InitStruct.Alternate = GPIO_AF7_USART2;
		HAL_GPIO_Init(VCP_TX_PORT, &GPIO_InitStruct);

		GPIO_InitStruct.Pin = VCP_RX_PIN;
		GPIO_InitStruct.Mode = GPIO_MODE_AF_PP;
		GPIO_InitStruct.Pull = GPIO_NOPULL;
		GPIO_InitStruct.Speed = GPIO_SPEED_FREQ_VERY_HIGH;
		GPIO_InitStruct.Alternate = GPIO_AF3_USART2;
		HAL_GPIO_Init(VCP_RX_PORT, &GPIO_InitStruct);
	}
}

void HAL_UART_MspGPIODeInit(UART_HandleTypeDef* huart)
{
	if(huart->Instance==USART2)
	{
		/* Peripheral clock disable */
		__HAL_RCC_USART2_CLK_DISABLE();

		/**USART2 GPIO Configuration
		PA2     ------> USART2_TX
		PA15 (JTDI)     ------> USART2_RX
		*/
		HAL_GPIO_DeInit(GPIOA, VCP_TX_PIN|VCP_RX_PIN);
	}
}
