lhr-solar/PS-PowerDistributionUnit/(commit log)

2025-09-12 TestBoard_TPS27SA08-Q1 (#3)
    * add TestBoard_TPS27SA08-Q1
    * revisions (dip switch for address, leds on gpio outputs, logic analyzer pinout?, ...)
    * logic analyzer fix and other little things
    * last revisions, export gerbers and pdf schematic
    [Calculations.kicad_sch, GPIO_Expander_LEDs.kicad_sch, Indicators.kicad_sch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]
2025-09-24 clean up PowerDistributionUnitLib symbols, embed datasheets, add vendor P/Ns for BOM
2025-09-24 archived TPS25983-based BBPDU
    [PowerDistributionUnit.kicad_pcb, PowerDistributionUnit.kicad_sch]
2025-09-24 update KiCad-Sharepoint
2025-09-27 actually add the old PDU project...
    [Indicators.kicad_sch, Monitoring.kicad_sch, PowerDistributionUnit.kicad_sch, eFuse Monitoring and Control.kicad_sch, eFuse.kicad_sch, eFuses.kicad_sch]
2026-01-16 BBPDU Mk1 (#4)
    * add KiCad project
    * initial schematic
    * fix gamer LED footprint thing, thanks Gemini
    * change new symbol libraries to relative paths, thanks Gemini
    * schematic updates (found switch, LED resistor values, LV sense ADC pin filter, removed unnecessary parallel resistors, switched to new SR), addressed review comments (input fuse, 3.3V LED, SPI naming fix)
    * fix pages order, fix duplicate C25
    * fix LeaderSOM footprint, assign proper ADC crystal footprint
    * import parts into PCB
    * routing one channel, ADDED PCB CONSTRAINTS
    * multichannel routing
    * aligned multichannel
    * one side HSS routing
    * fix input cap footprint
    * fix TPS27SA08-Q1 datasheet
    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
    [ControlGroup.kicad_sch, LeaderSOM.kicad_sch, OutputGroup.kicad_sch, Outputs.kicad_sch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]
2026-03-03 BBPDU Mk1 RevB (#6)
    * update adc reference to use internal reference (open) with jumper option
    * change ADC - reading voltage to resistor divider with option to reference to GND or 1.65V
    * change ADC AVDD and AGND connections to regular 3.3V and GND
    * make input protection use b2b FETs
    * update KiCad-Sharepoint
    * update LeaderSOM symbol and SPI pinout (bottom) - need to swap SPI2 and SPI3 names, remove local library copy of LeaderSOM symbol
    * change LSOM footprint to centered LSOM footprint, make centered LSOM footprint plated to address hidden pins on LSOM symbol
    * update PCB from schematic
    * layout/routing for input protection
    * fix centered LSOM footprint 3D model, update footpri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
    [ControlGroup.kicad_sch, HSS_TPS27SA08-Q1.kicad_sch, Indicators.kicad_sch, InputProtection.kicad_sch, LeaderSOM.kicad_sch, Outputs.kicad_sch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]
2026-04-12 Add embedded sharepoint, MCP23S17 driver and basic tests (#5)
    * rename software folder to firmware
    * set up embedded sharepoint
    * fix makefile showing flash successful even when not (fix in Embedded-Sharepoint)
    * MCP23S17 GPIO expander driver
    * update makefile to give build failure message, remove madefile when running make clean
    * add blank line to nix_thing.sh
    * fix TEST capitalization in makefile, change formatting
    * add MCP23S17 datasheet
    * change pin type to uint16_t because HAL convention
    * add register descriptions
    * add enum comments
    * address addressing double left-shift, comments
    * move defines out of c file to header file
    * update function documentation comments, add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
    [MCP23S17.c, MCP23S17.h, MCP23S17_in_test.c, MCP23S17_int_test.c, MCP23S17_out_test.c, MakeAllTests_TestBoard_TPS27SA08-Q1.py, TestBoard_TPS27SA08-Q1_CubeMX.ioc, TestBoard_TPS27SA08-Q1_Pins.h]
2026-05-10 ADS131M08-Q1 driver (#10)
    (see PR #7)
    * add all the ADS131M08-Q1 driver stuff from before...
    * attempt add github action
    * try github action again
    * attempt github action again
    * fix copy paste errors in SPI
    * remove erroneous comment in GPIO
    * fix convoluted conversion code
    [ADS131M08-Q1.c, ADS131M08-Q1.h, ADS131M08Q1_Convert.c, ADS131M08Q1_LockUnlock_Status.c, ADS131M08Q1_StandbyWakeup.c, LSOM_Blinky_Printy.c, LSOM_S_Pins.h, LSOM_U_Pins.h]
2026-06-24 HSS control (#12)
    * HSS control
    * remove disable interrupts from test error handler
    * add description and example part number, add datasheet
    * update delay
    * add function descriptions, fix typo in driver description
    * remove debug printf statements
    * add warning on keeping everything within one task for HSSControl to description
    * remove filtering faulted channels from output en
    * add status enum instead of true false for returns
    * add SPI reconfiguration function before communicating with SR
    * add functions for getting EN and fault state of a channel (for CAN stuff)
    * update indentation
    * corrected LSOM pins
    * add comment on ReconfigSPI usage
    [HSSControl.c, LSOM_S_Pins.h, LSOM_U_Pins.h, PDU_Mk1_HSSControl.c, PDU_Mk1_HSSControl.h, PDU_Mk1_OutputConfig.h, ShiftRegister_SPI.c, ShiftRegister_SPI.h]
2026-06-25 Current sensing (#11)
    * current sensing code
    * fix copy paste errors in current sensing header
    * make initial offset calculation average of multiple samples
    * remove underscore between current sensing
    * add fs
    * add conditional to avoid trying to use inaccessible ADC on rev A (pinout issue)
    * add SPI reconfiguration function before communicating with ADC
    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
    [ACS3704x-010B3.c, ACS3704x-010B3.h, ACS_Current_Sensing.c, ADS131M08-Q1.c, ADS131M08-Q1.h, ADS131M08Q1_Convert.c, ADS131M08Q1_StandbyWakeup.c, PDU_Mk1.h]
2026-10-14 Main program (#15)
    * CAN and tasks stuff
    * remove old tests because causing Github check to fail
    * fix MakeAllTests github check
    * add void argument for RTOS tasks
    * remove redundant while(1)
    * fix HSS Control task description
    * remove unused print status task for now
    * blank lines
    * make tasks less fat
    * move CAN test init task internal to test (other tests soon)
    * internal init task for current sensing task
    * internal init task for HSSControl, separate all outputs on test
    * decrease blink task priority
    * increase frequency of HSSControl task
    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
2026-11-02 27_reva_pdu (#16)
    * initial commit
    * moved kicad sharepoint
    * fixed gitignore + kicad sharepoint
    * removed workflows
    * fixed gitkeep
    * root + jet lagged
    * progress before drive back to austin
    * added hss and driving back from houston
    * before sleep progress-added out put and current reverse stuff for elcon
    * init schem super simple..
    * aesthetic added
    * updated kicad and started on gamer led
    * progress
    * added gamer led but need to make pretty
    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
